drkntz/radiotelescope-PCB/README.md

# News
First place (tie), 2023 IEEE Susquehanna Section Capstone Competition. Project paper here: https://r2.ieee.org/susquehanna/wp-content/uploads/sites/24/2023/07/IEEE_RadioTelescopeControlSystem_Report.pdf
 
# Radio Telescope PCB
This Repository contains the design files for a control PCB for Penn State Harrisburg Radio telescope project. 

This project runs an embedded microcontroller PCB which controls the alt-az motor system for pointing a 3 meter dish. 
It communicates over USB with a PC.

Firmware repository: https://github.com/drkntz/radiotelescope-firmware

PC software: https://github.com/RidhaChowdhury/MiniRadioTelescope

Created by Zach Martin and Aaron Olsen.
Init date October 2022.

# System Overview

Block Diagram of Radio Telescope:

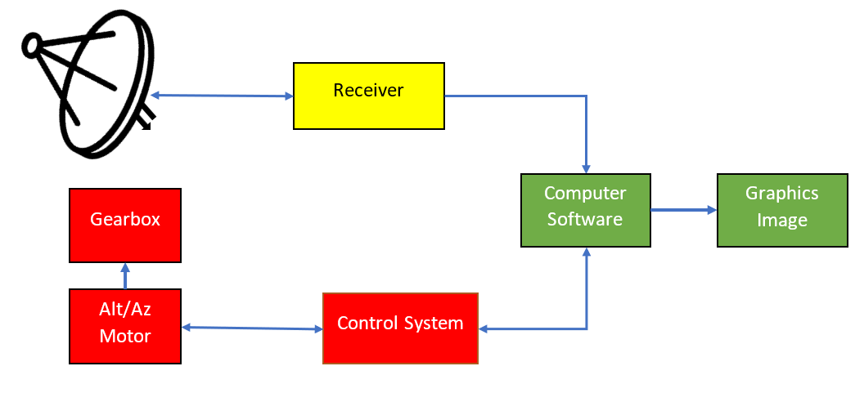
[picture p1: Docs/System_Overview.png]
System_Overview


Block Diagram of Radio Telescope Controller:

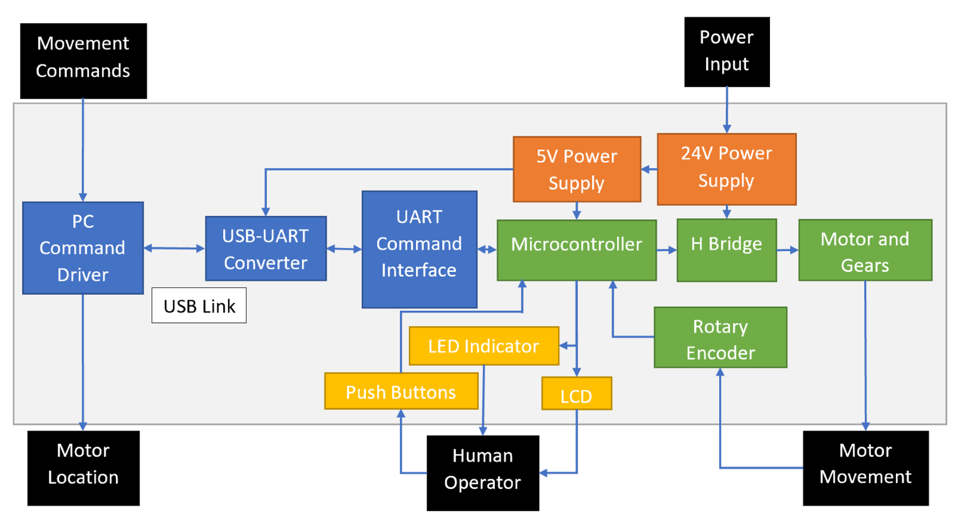
[picture p2: Docs/Control_System_Diagram.png]
Control_System_Diagram


# Schematic

PDF Printout

Schematic Pages:
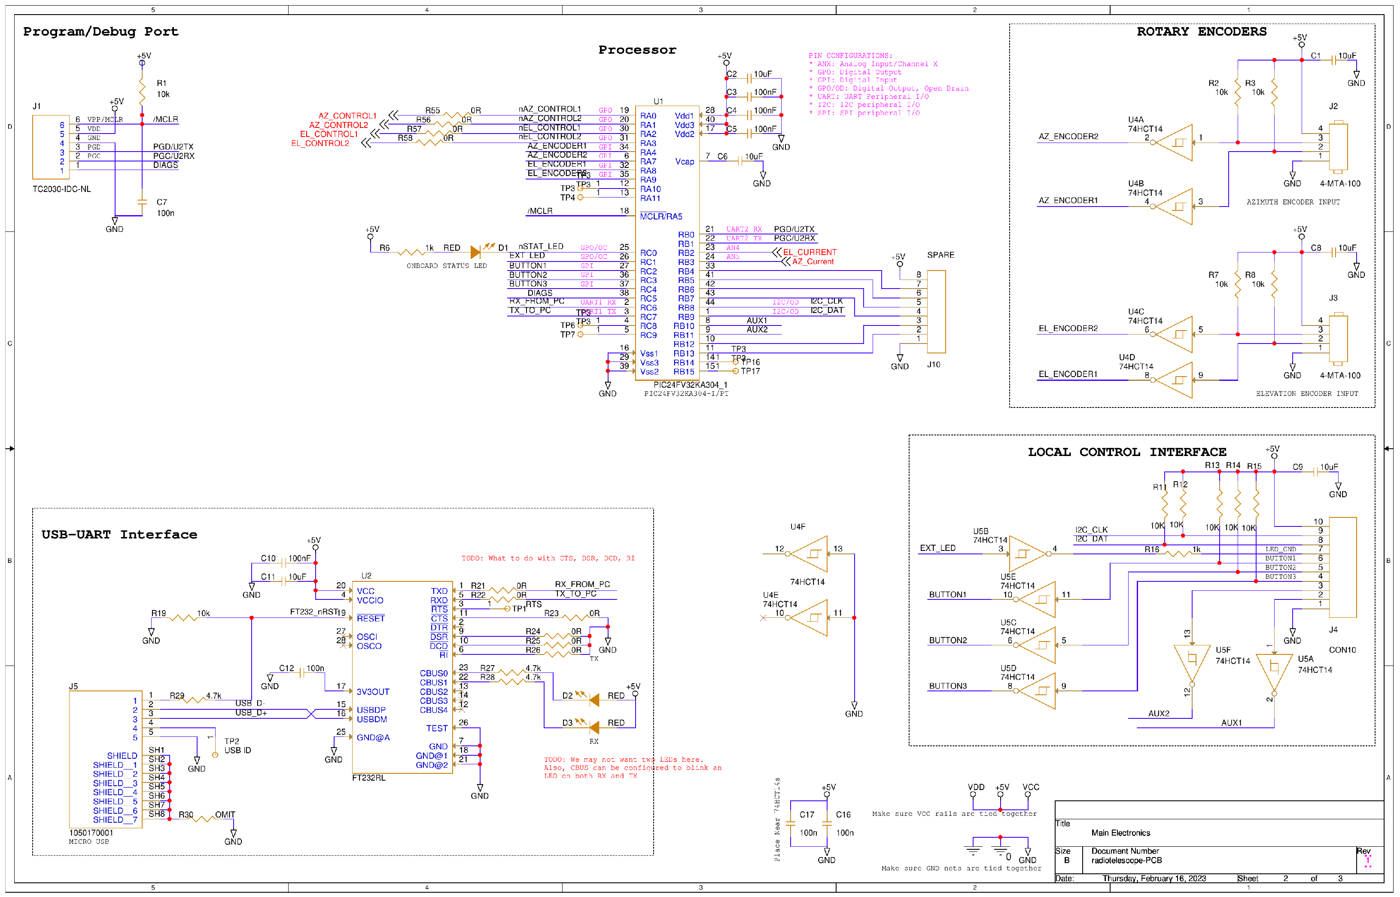
[picture p3: Docs/radiotelescope-SCH-V01_1.png]
SCH_1

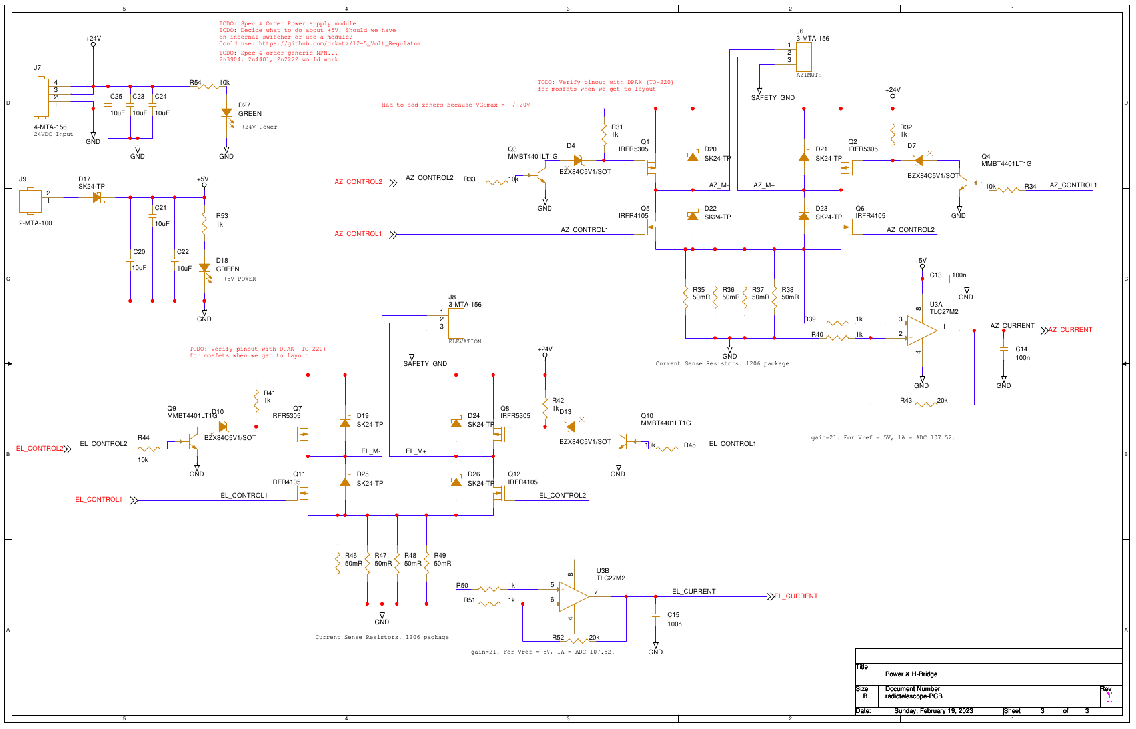
[picture p4: Docs/radiotelescope-SCH-V01_2.png]
SCH_2


# PCB Layout
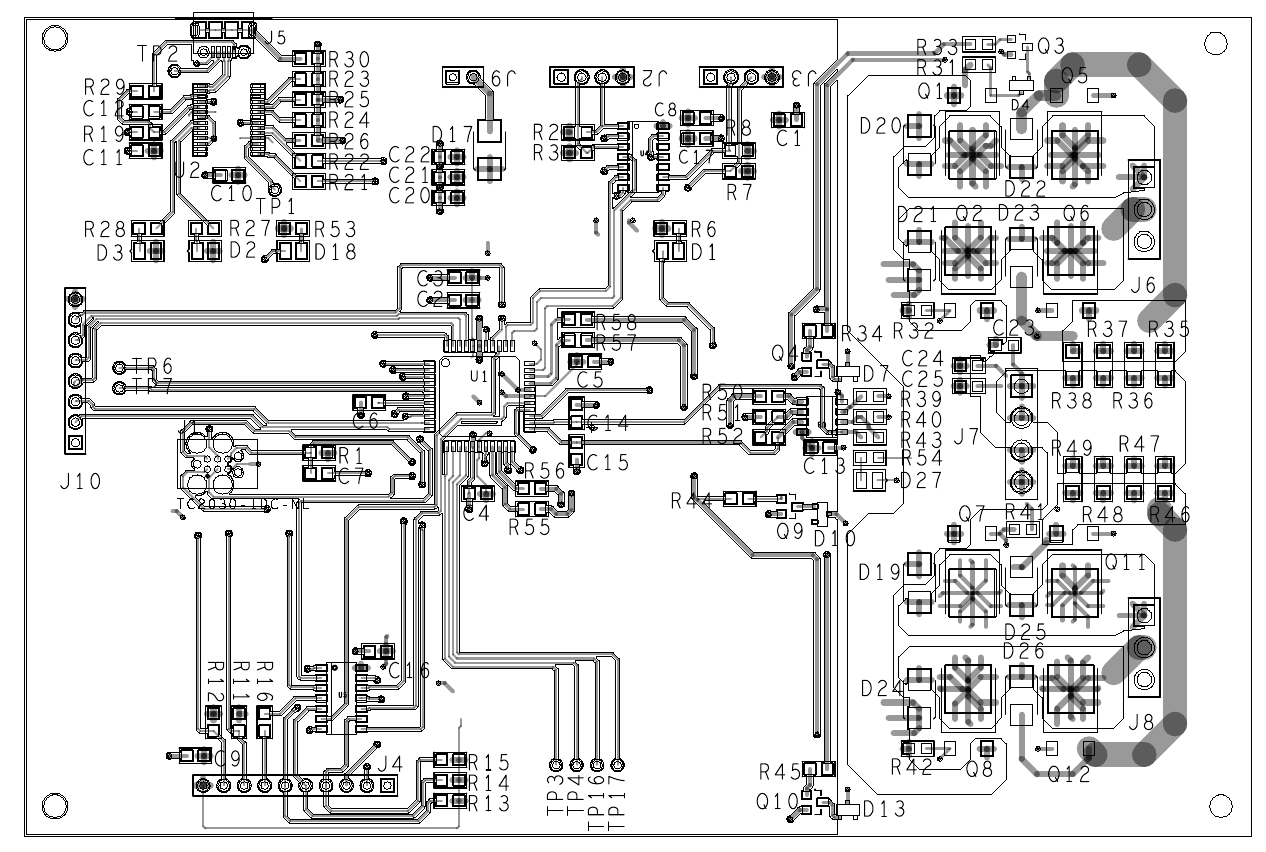
[picture p5: Docs/radiotelescope-LAY-V01.png]
PCB


# PCB 3-D Model
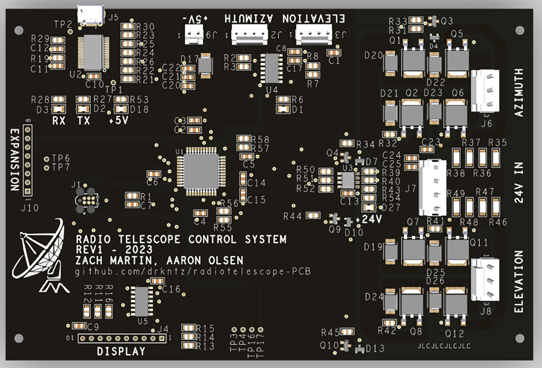
[picture p6: Docs/radiotelescope-3D-V01.png]
3D


# Completed Design

Assembled PCB:

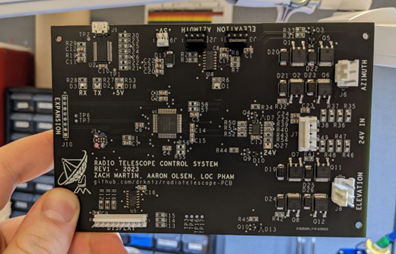
[picture p7: Docs/Assembled_PCB.png]
Assembled_PCB


Assembled System, including 3 foot prototype dish and alt-az motor system.

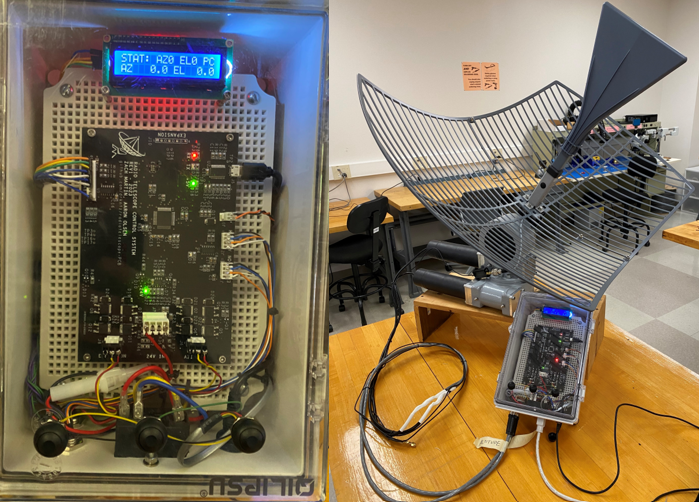
[picture p8: Docs/Assembled_System.png]
Assembled_System


# Example Video of Prototype

https://youtu.be/-fnis7qi-ZQ
