drkntz/radiotelescope-PCB/Main Project/allegro/gerbers/Screenshot 2023-02-20 102508.png

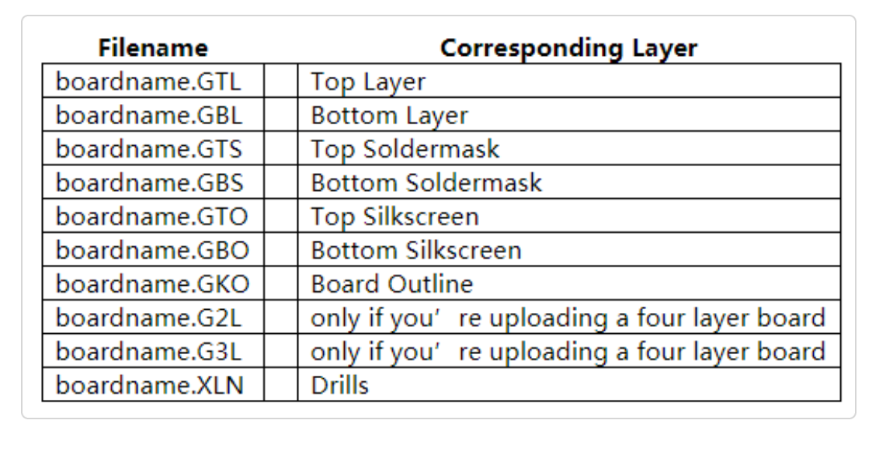
Main Project/allegro/gerbers/Screenshot 2023-02-20 102508.png
