drkntz/radiotelescope-PCB/Main Project/RADIOTELESCOPE.png

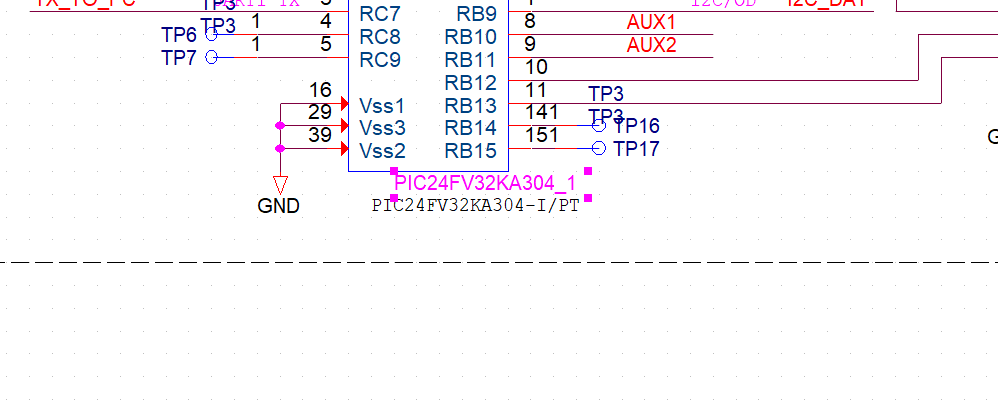
Main Project/RADIOTELESCOPE.png
