drkntz/radiotelescope-PCB/Simulation/hbridge/HBRIDGE.png

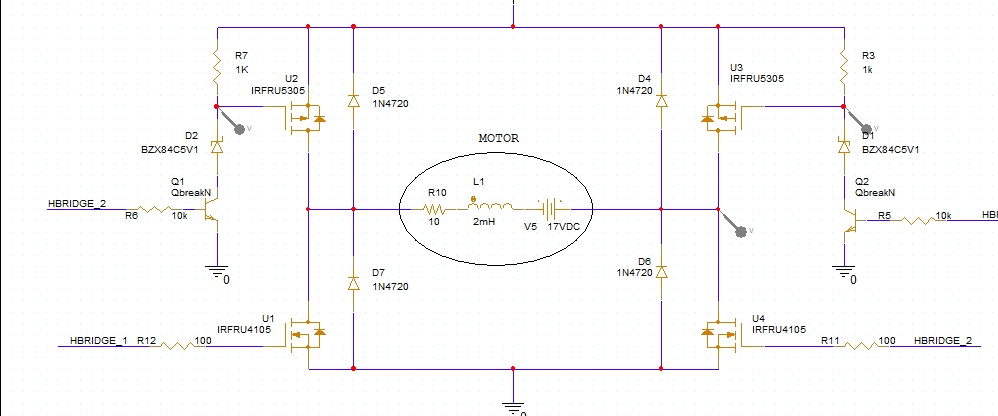
Simulation/hbridge/HBRIDGE.png
