drkntz/radiotelescope-PCB/Main Project/symbols/TC2030-IDC-NL.STEP

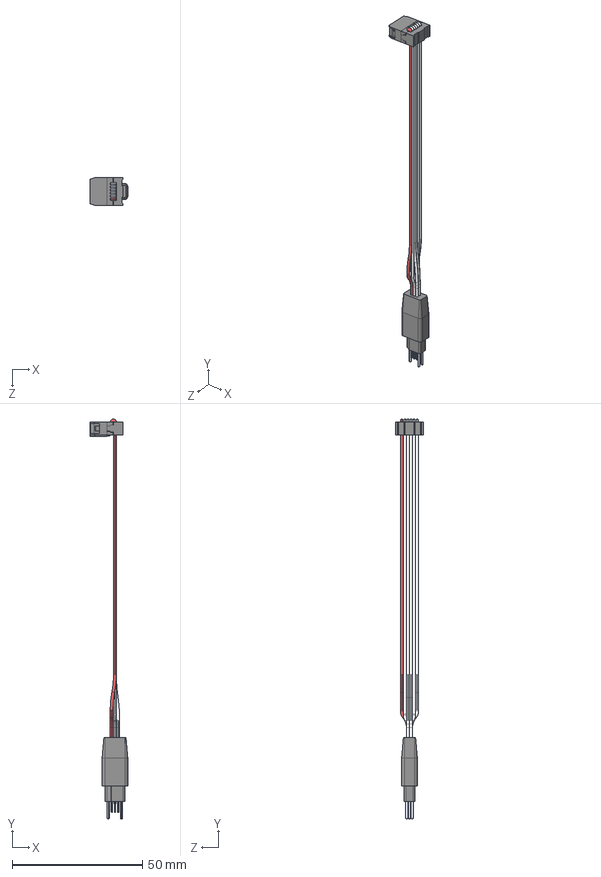
[picture p12: CAD file, 2023-02-01]
Main Project/symbols/TC2030-IDC-NL.STEP
14.5 x 153.6 x 10.7 mm
