drkntz/radiotelescope-PCB/Main Project/symbols/QFP80P1200X1200X120-44N.STEP

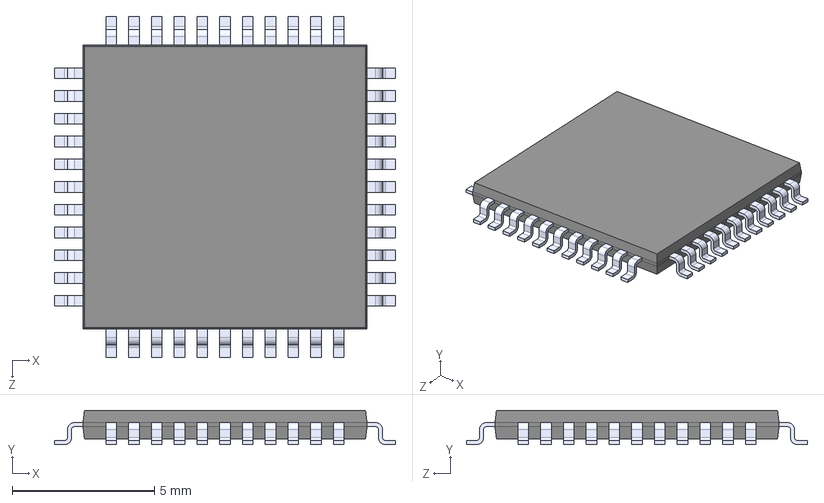
[picture p13: CAD file, 2023-01-16]
Main Project/symbols/QFP80P1200X1200X120-44N.STEP
12.0 x 1.20 x 12.0 mm
