drkntz/radiotelescope-PCB/Main Project/symbols/INTERFACE-FT232RL(SSOP28).STEP

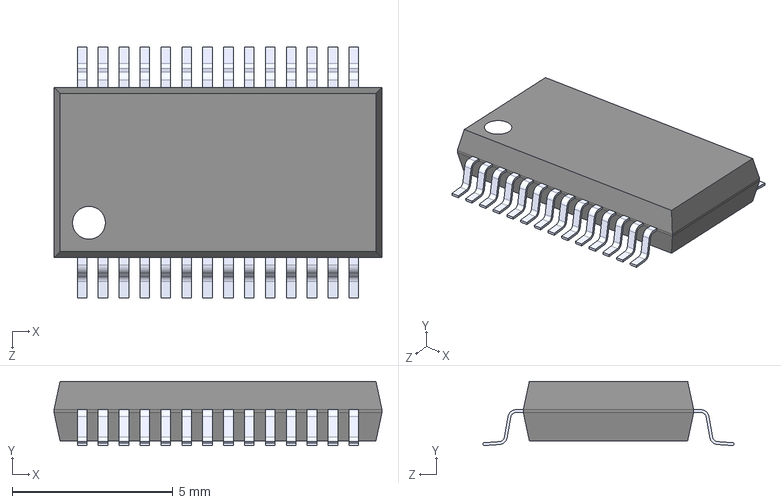
[picture p14: CAD file, 2022-11-22]
Main Project/symbols/INTERFACE-FT232RL(SSOP28).STEP
10.2 x 2.00 x 7.80 mm
