drkntz/radiotelescope-PCB/Main Project/symbols/1050170001.STEP

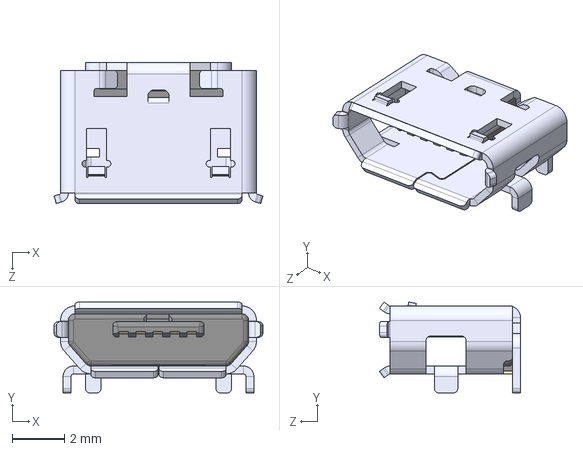
[picture p15: CAD file, 2022-11-22]
Main Project/symbols/1050170001.STEP
8.00 x 3.48 x 5.40 mm
