drkntz/radiotelescope-PCB/(list of files, cad)

Other CAD files:
Main Project/symbols/molex_1050170001.psm
Main Project/symbols/ssop28-065-102x52mm.psm
Main Project/symbols/tag_tc2030-idc-nl.psm
