drkntz/radiotelescope-PCB/Simulation/Simulation_Results.docx

# H-Bridge Simulation Data With PSPICE Default Parts

Simulation data from a simulation of H-bridge control. Simulated 11/23/2022 by Zach Martin.

Figure 1: Simulation Schematic

Figure 2: Simulation result

# Simulation With Vendor SPICE models 11/24/22

Imported vendor SPICE models, see “spice models” folder

Zach Martin, 11/24/22
