drkntz/radiotelescope-PCB/Main Project/allegro/radiotelescope-gerber-drawing.pdf

# R2TP3

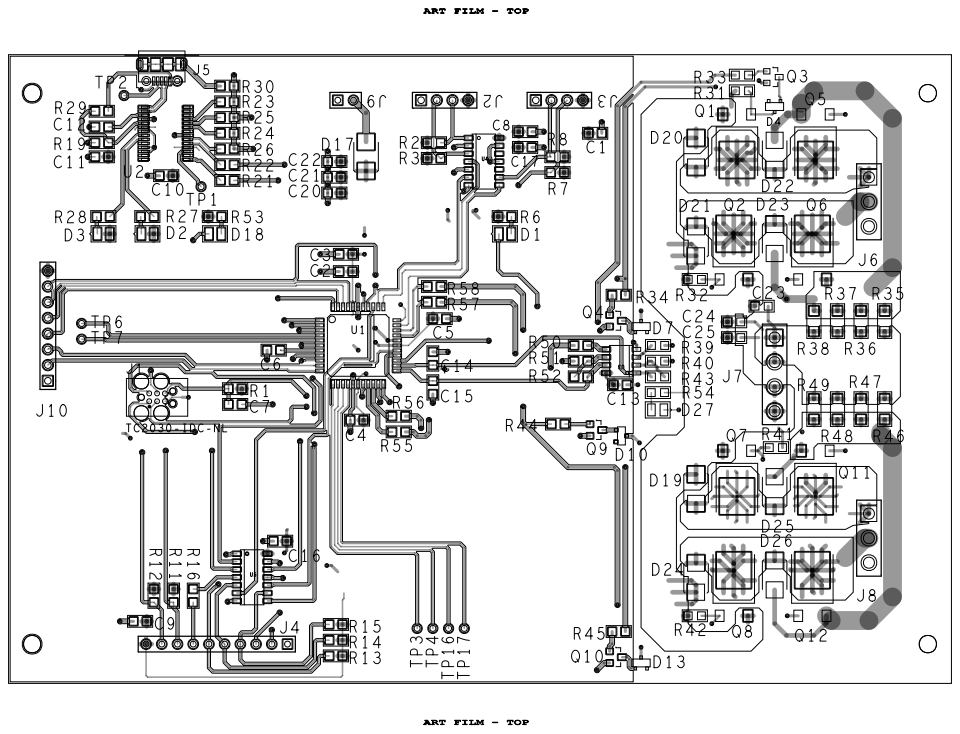
[picture p19: page 1]

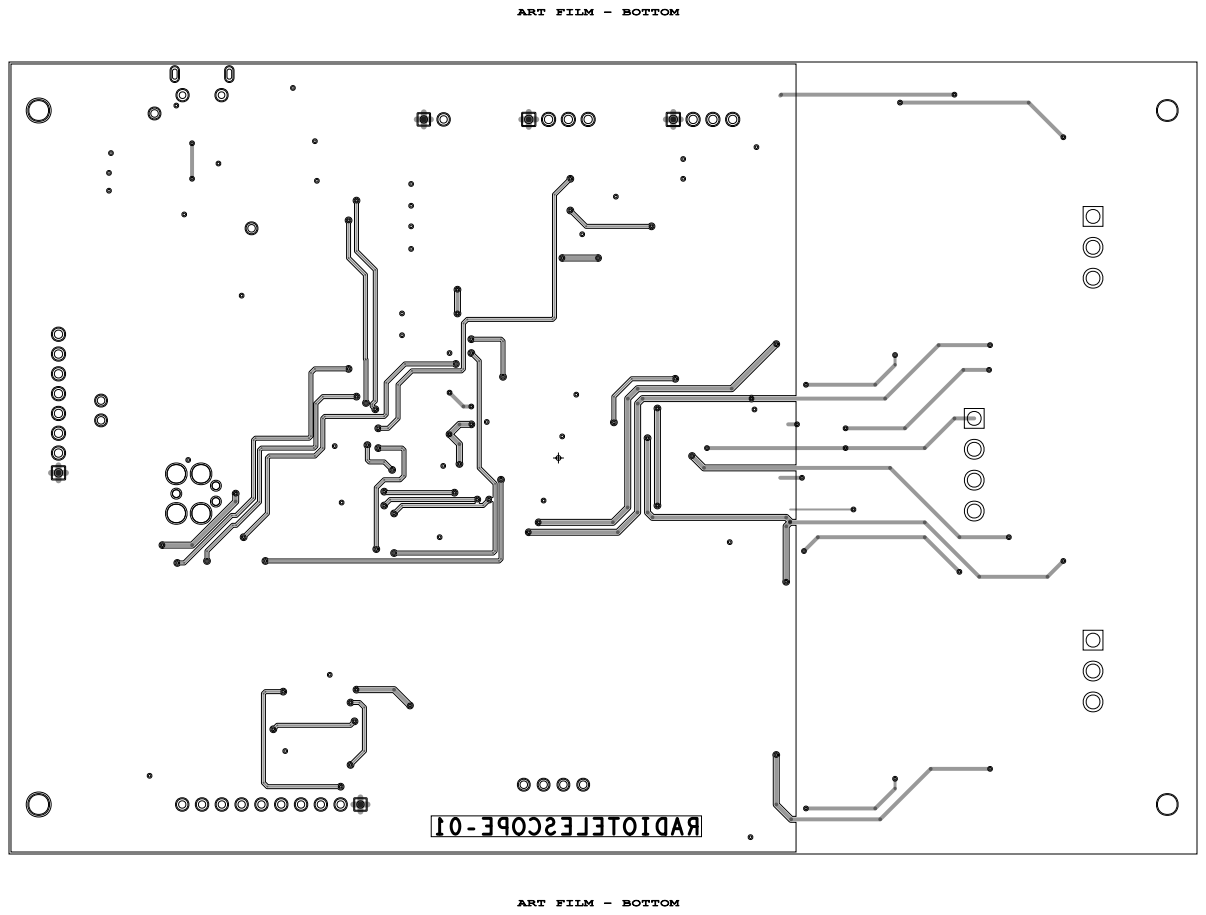
[picture p20: page 2]

ART FILM - BOTTOM

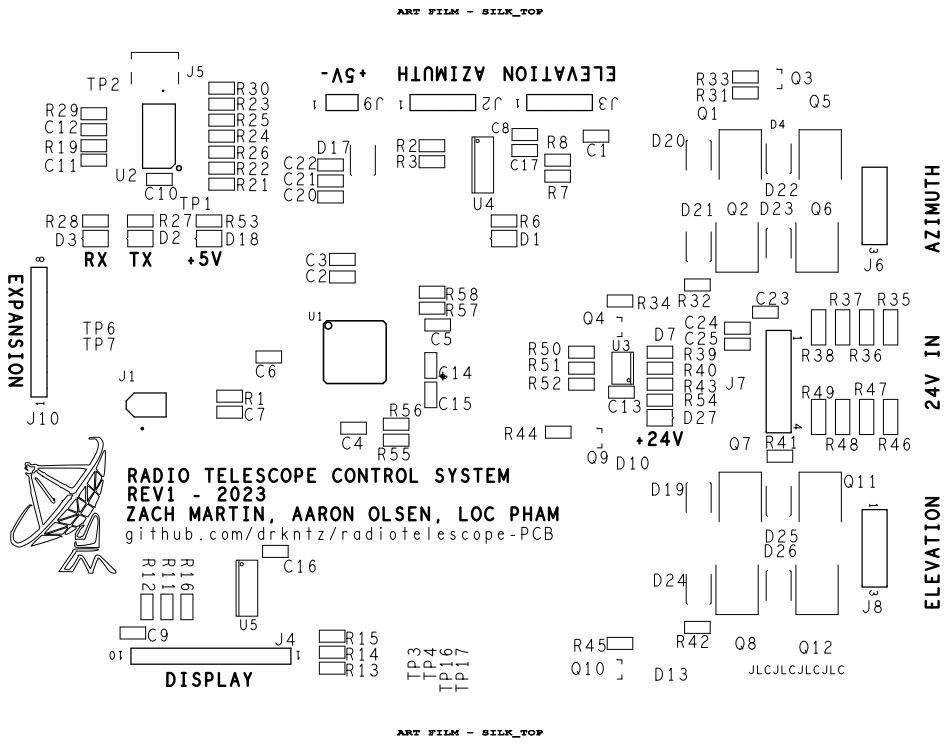
[picture p21: page 3]

RADIO TELESCOPE CONTROL SYSTEM
REV1 - 2023
ZACH MARTIN, AARON OLSEN, LOC PHAM
github.com/drkntz/radiotelescope-PCB

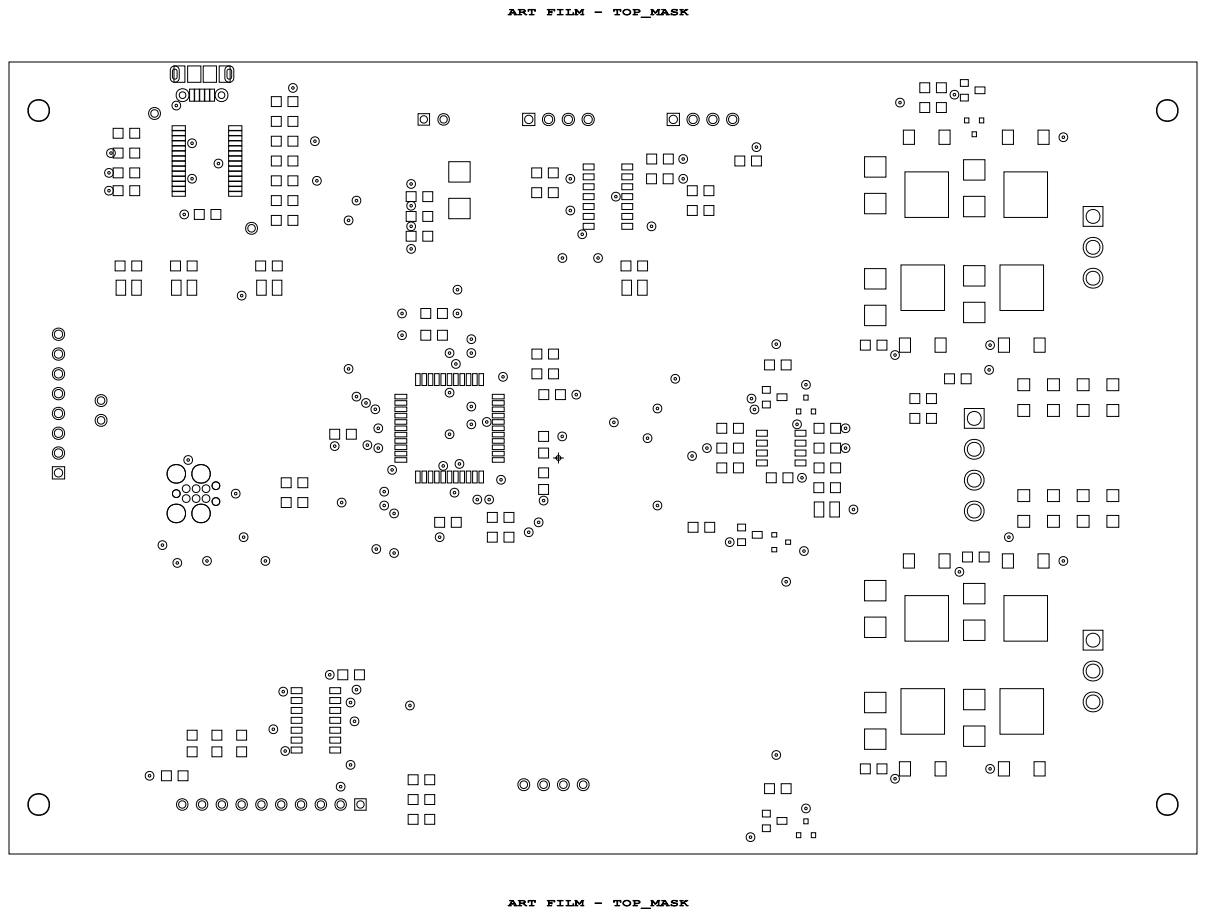
[picture p22: page 4]
ART FILM - TOP_MASK

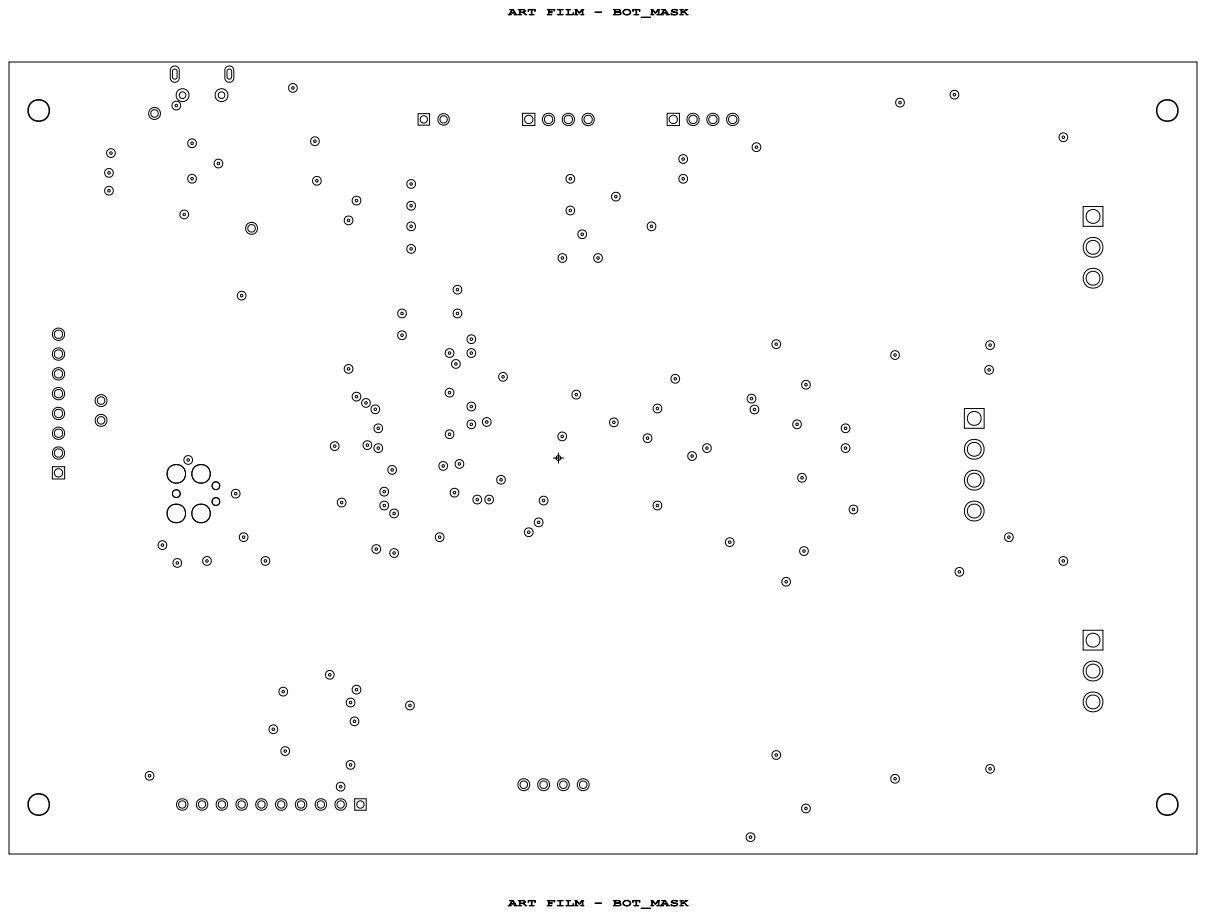
[picture p23: page 5]
ART FILM - BOT_MASK

ART FILM - BOARD_GEO

ART FILM - BOARD_GEO
