drkntz/radiotelescope-PCB/Main Project/allegro/radiotelescope-gerber-pdf.pdf

# R2TP3



ART FILM - BOTTOM

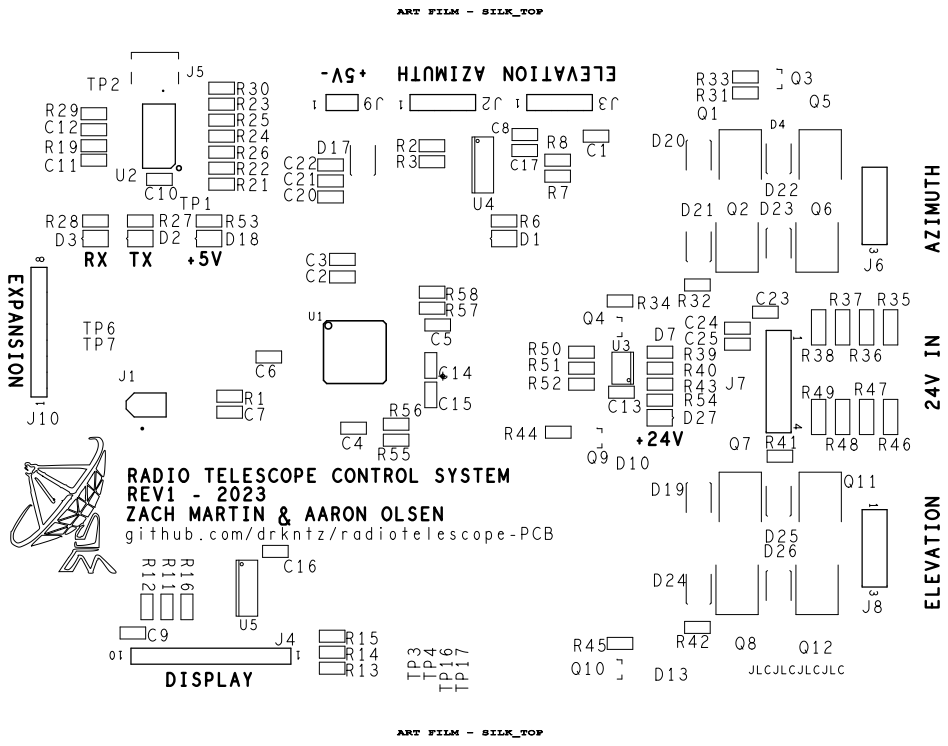
[picture p24: page 3]

RADIO TELESCOPE CONTROL SYSTEM
REV1 - 2023
ZACH MARTIN & AARON OLSEN
github.com/drkntz/radiotelescope-PCB

ART FILM - TOP_MASK

ART FILM - BOT_MASK

ART FILM - BOARD_GEO

ART FILM - BOARD_GEO
