drkntz/radiotelescope-PCB/Main Project/allegro/radiotelescope.pdf

5.85

6.00 TP4

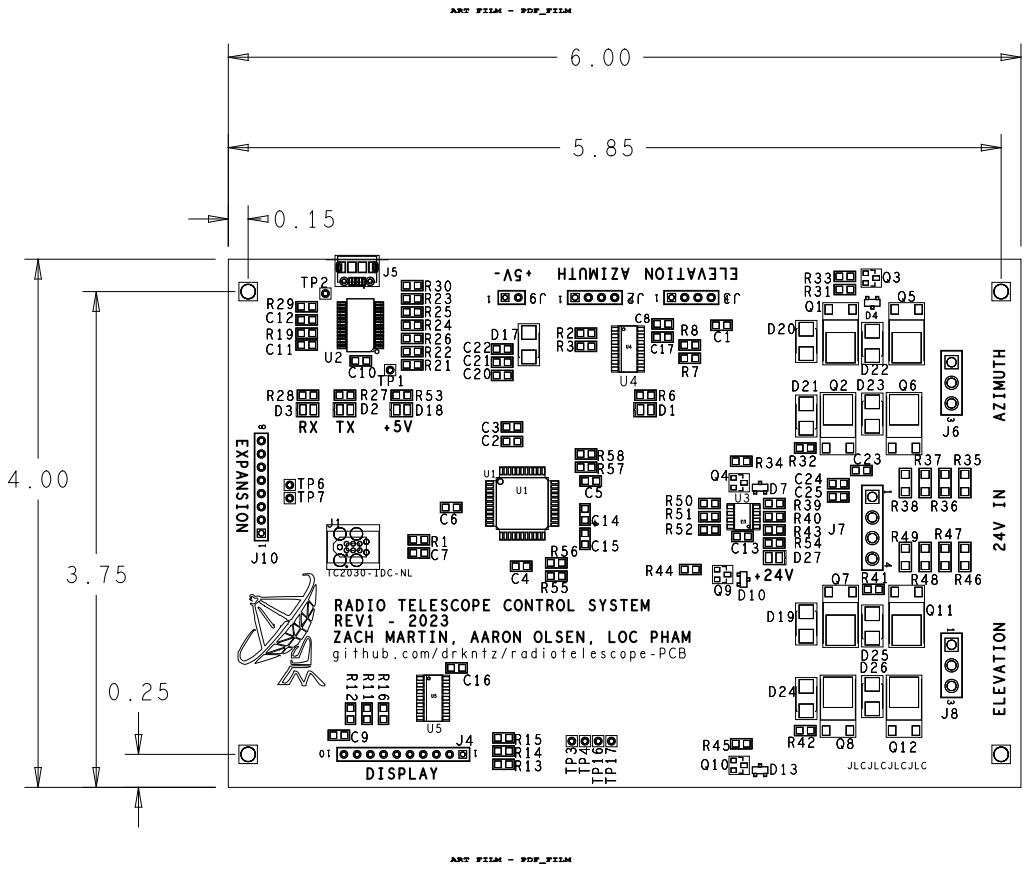
[picture p25: page 1]
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
