drkntz/radiotelescope-PCB/Main Project/allegro/radiotelescope-PCB.pdf

# R2TP3

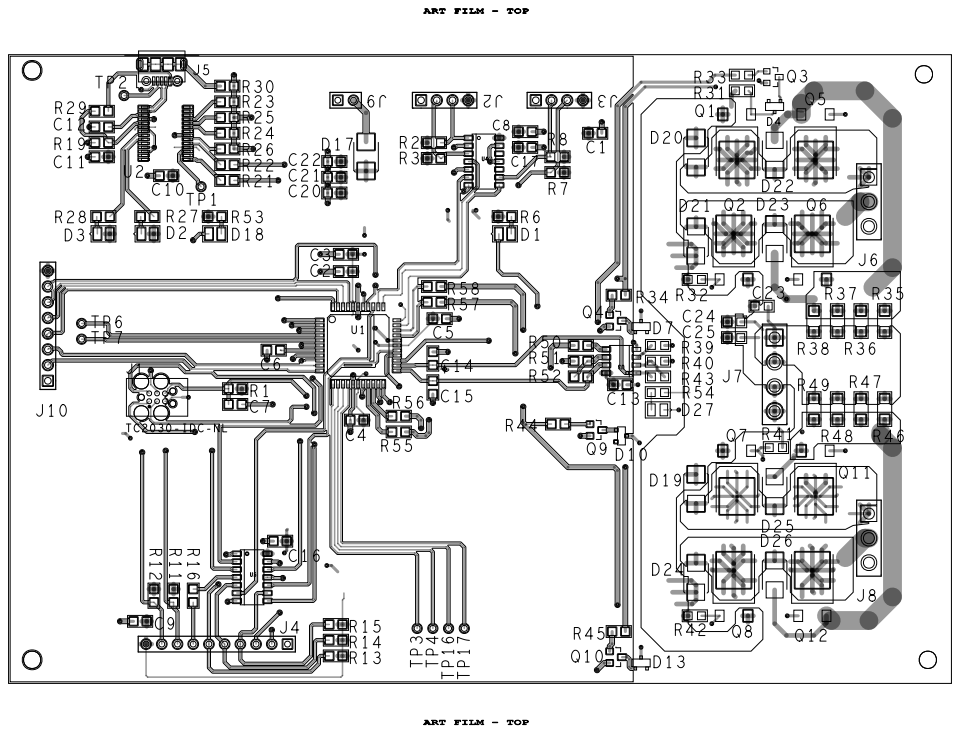
[picture p26: page 1]

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

ART FILM - BOARD_GEO

ART FILM - BOARD_GEO
