drkntz/radiotelescope-PCB/Simulation/hbridge/radiotelescope.pdf

D | D

# Radio Telescope Control System

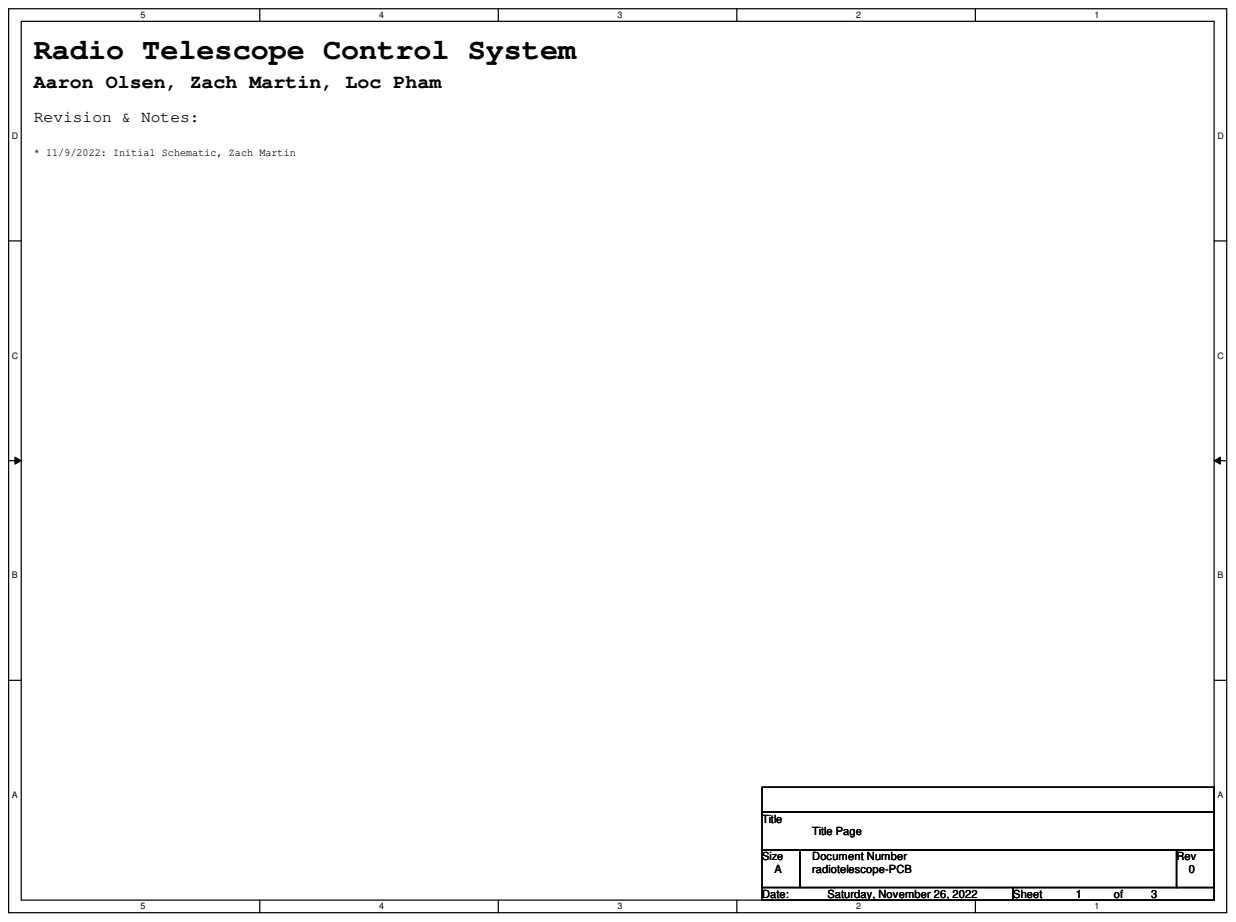
[picture p27: page 1]
Revision & Notes:; Title; Size; Document Number; Rev; Date:; Sheet; radiotelescope-PCB; Title Page; 3Saturday, November 26, 2022

Aaron Olsen, Zach Martin, Loc Pham

* 11/9/2022: Initial Schematic, Zach Martin

## ROTARY ENCODERS

## Program/Debug Port

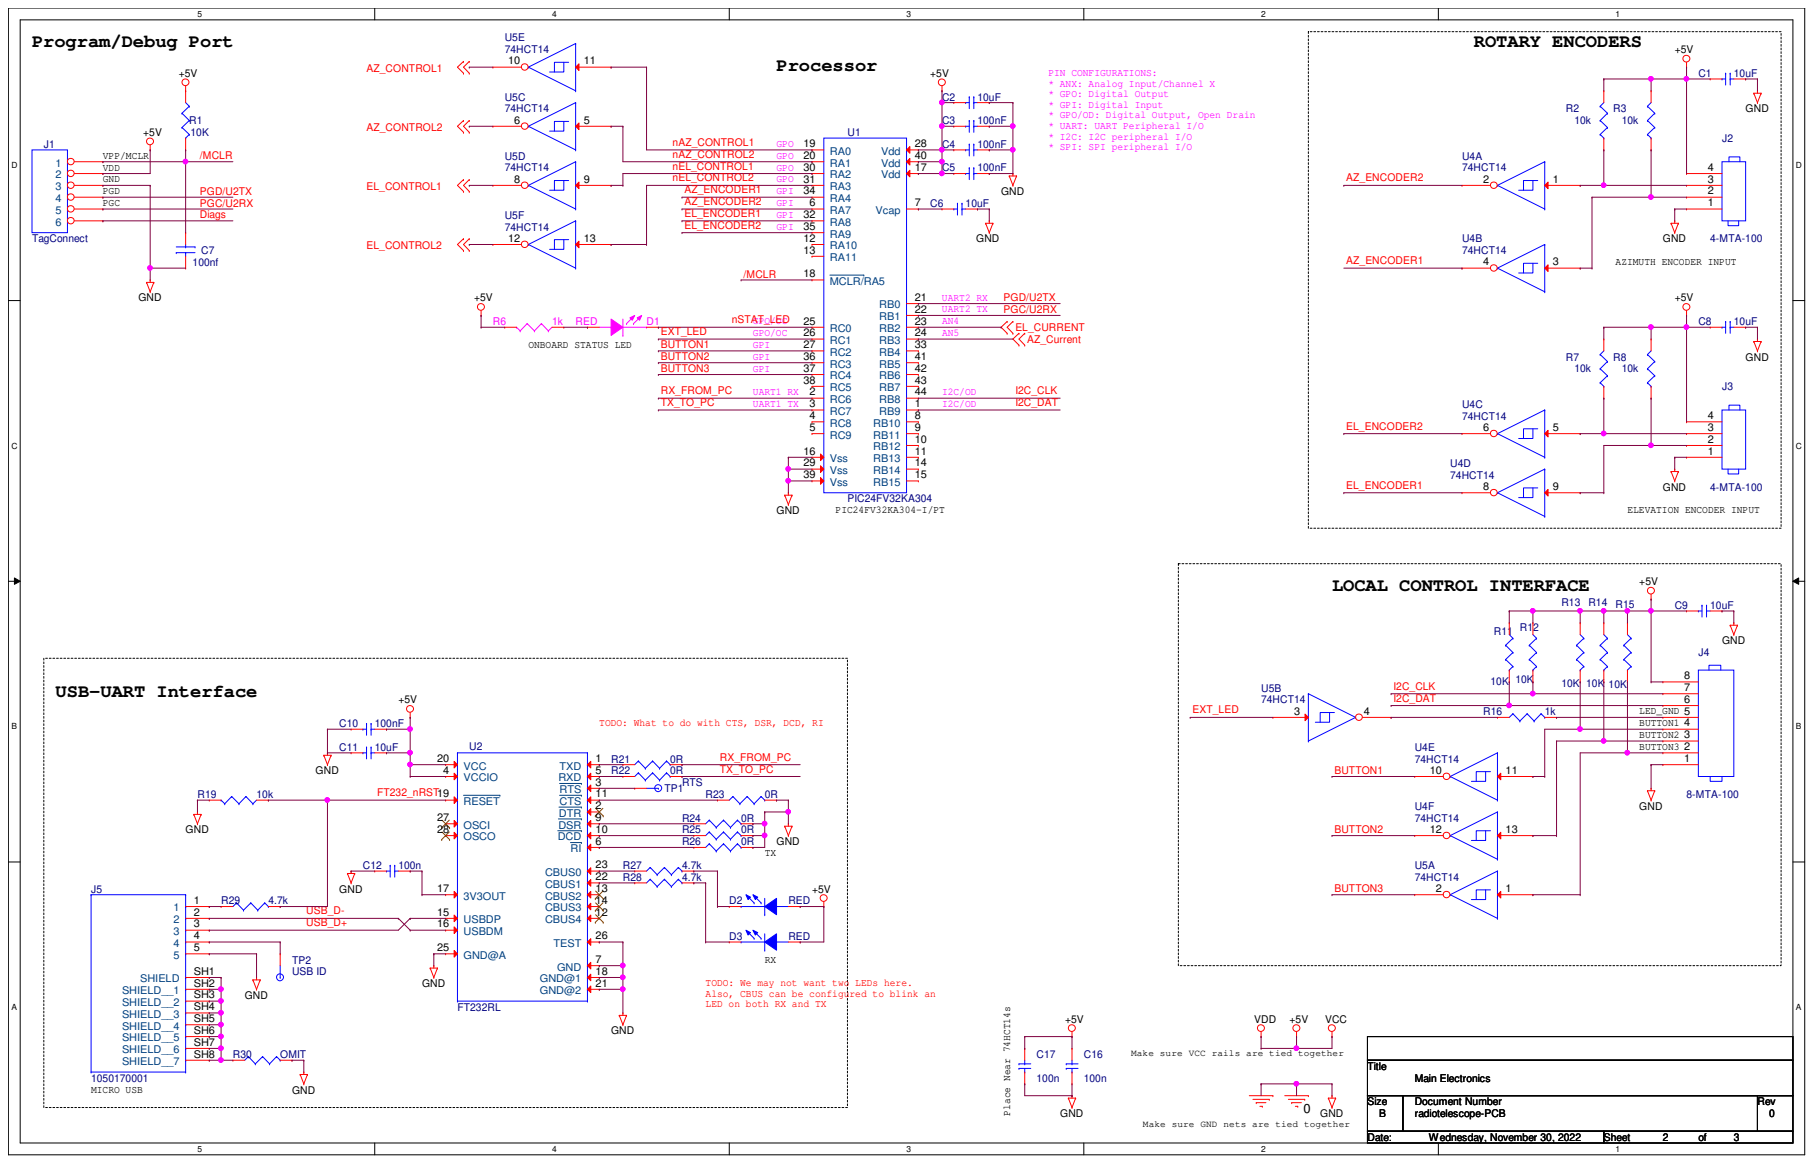
[picture p28: page 2]

PIN CONFIGURATIONS:
* ANX: Analog Input/Channel X
* GPO: Digital Output
* GPI: Digital Input
* GPO/OD: Digital Output, Open Drain
* UART: UART Peripheral I/O
* I2C: I2C peripheral I/O
* SPI: SPI peripheral I/O

TODO: What to do with CTS, DSR, DCD, RI

BUTTON1 4
BUTTON2 3

TODO: We may not want two LEDs here.
Also, CBUS can be configured to blink an
LED on both RX and TX

Make sure VCC rails are tied together

Make sure GND nets are tied together

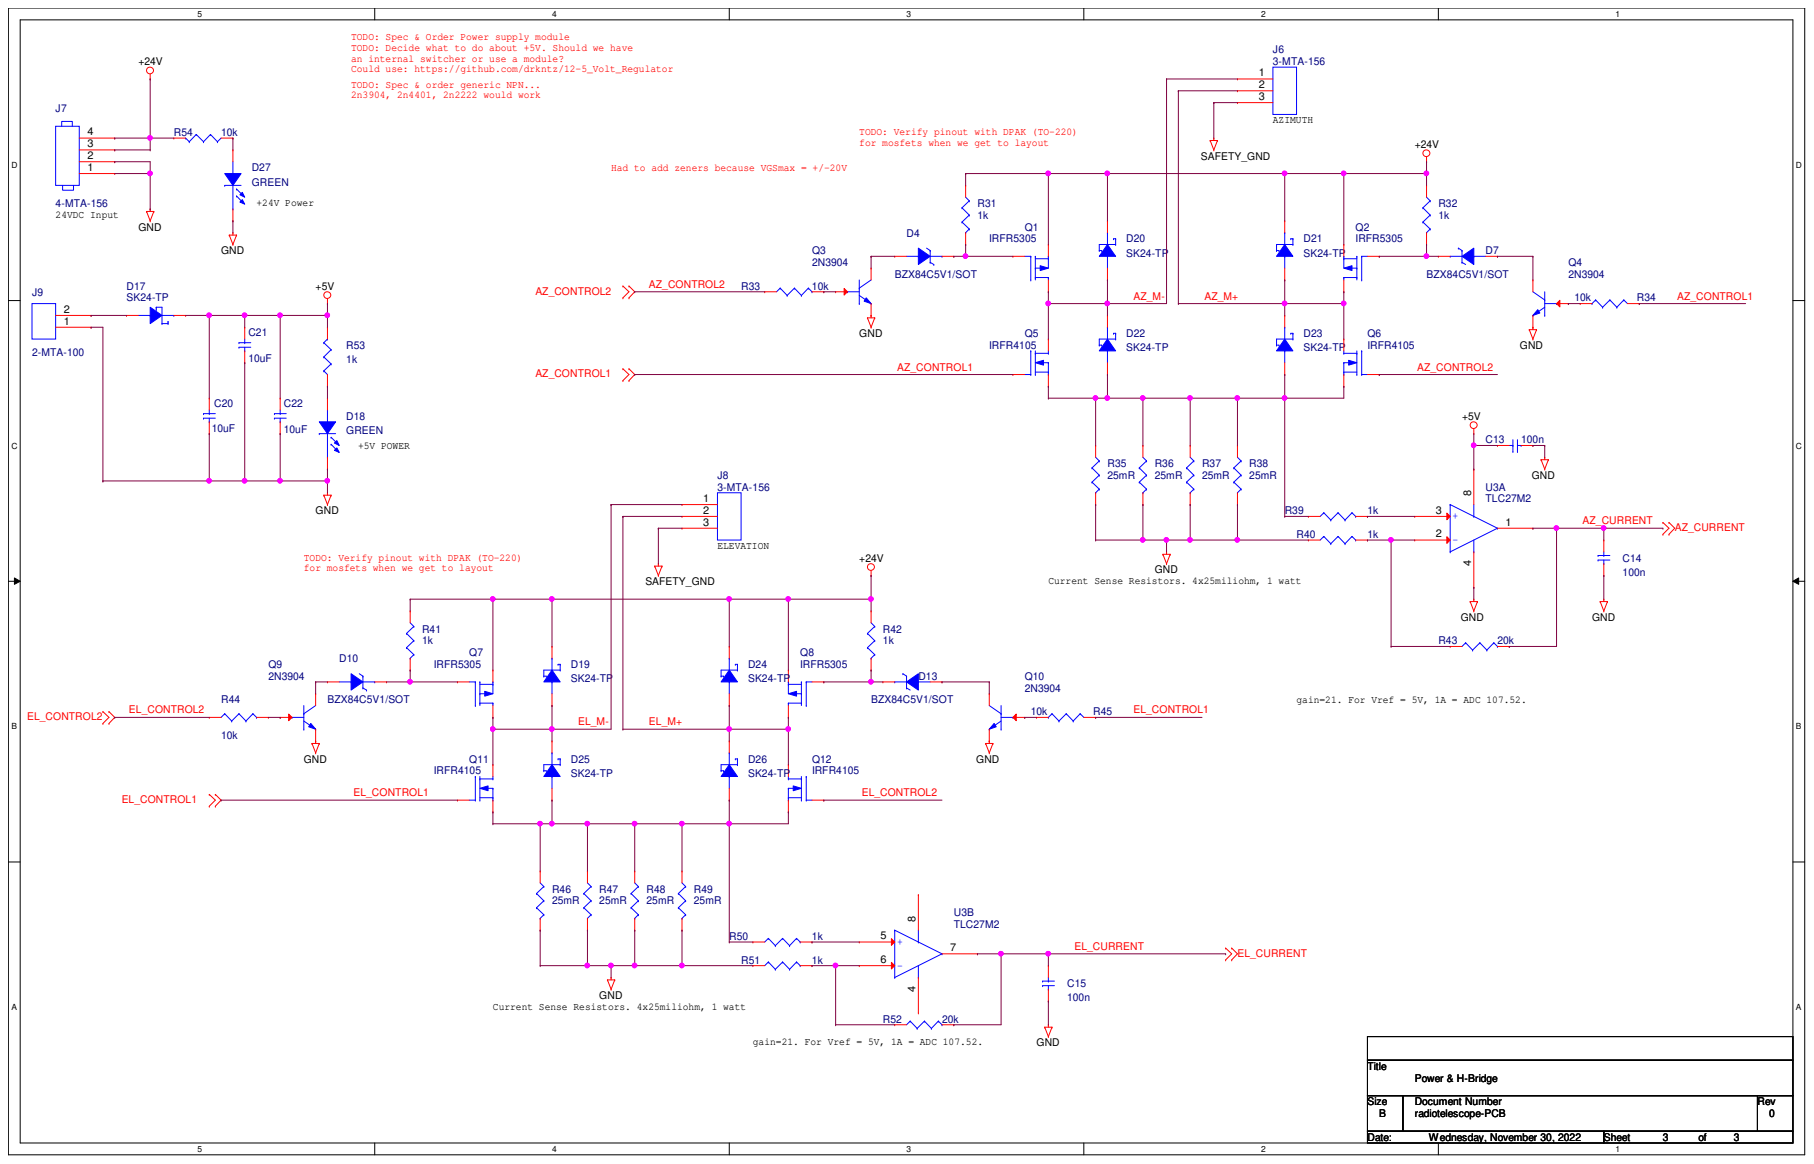
[picture p29: page 3]

TODO: Spec & Order Power supply module
TODO: Decide what to do about +5V. Should we have
an internal switcher or use a module?
Could use: https://github.com/drkntz/12-5_Volt_Regulator
TODO: Spec & order generic NPN...
2n3904, 2n4401, 2n2222 would work

TODO: Verify pinout with DPAK (TO-220)
for mosfets when we get to layout

Had to add zeners because VGSmax = +/-20V

Current Sense Resistors. 4x25miliohm, 1 watt

gain=21. For Vref = 5V, 1A = ADC 107.52.
