drkntz/radiotelescope-PCB/Simulation/hbridge/hbridge.pdf

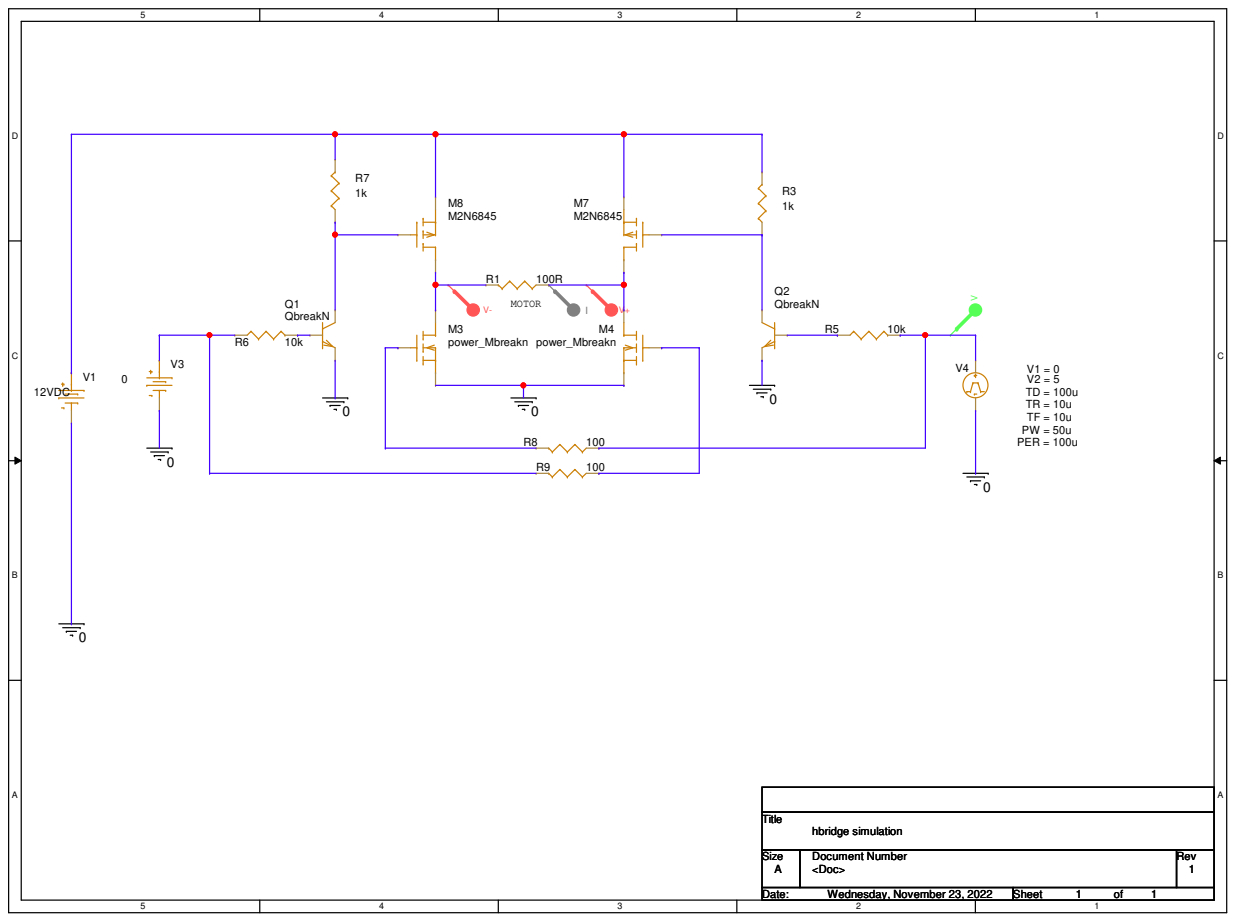
[picture p30: page 1]
