drkntz/radiotelescope-PCB/(list of files, drawings)

Other design files:
Main Project/DESIGN1.DSN
Main Project/Design1.opj
Main Project/LIBRARY1.OLB
Main Project/RADIOTELESCOPE.DSN
Main Project/radiotelescope.opj
Main Project/symbols/1050170001.OLB
Main Project/symbols/INTERFACE-FT232RLSSOP28.OLB
Main Project/symbols/TC2030-IDC-NL.OLB
Simulation/hbridge/HBRIDGE.DSN
Simulation/hbridge/hbridge.opj
Simulation/spice models/IRFR4105.OLB
Simulation/spice models/IRFR5305.OLB
