drkntz/radiotelescope-PCB/(commit log)

2022-11-09 Started main schematic. Added processor & debug header
    [RADIOTELESCOPE.DSN, radiotelescope.opj]
2022-11-22 Added FT232 USB-UART interface. Added PDF printout & README
    [1050170001.OLB, 1050170001.STEP, DESIGN1.DSN, Design1.opj, INTERFACE-FT232RL(SSOP28).STEP, INTERFACE-FT232RLSSOP28.OLB, RADIOTELESCOPE.DSN, molex_1050170001.psm]
2022-11-23 Simulation for H-bridge. Added H-bridge to main schematic
    [HBRIDGE.DSN, RADIOTELESCOPE.DSN, hbridge.opj, radiotelescope.opj]
2022-11-24 Added Zener diodes to H-bridge to protect PMOS Vsg_max. Import vendor SPICE models & re-ran simulation. Update README.
    [HBRIDGE.DSN, IRFR4105.OLB, IRFR5305.OLB, RADIOTELESCOPE.DSN, hbridge.opj, radiotelescope.opj]
2022-11-26 add display interface w/leds & PB. Add encoders, added opamp tlc27m2, connected inter-page references to main MCU
    [RADIOTELESCOPE.DSN, hbridge.opj, radiotelescope.opj]
2022-11-30 added 74HCT14 buffers to i/o and H-bridge drivers
    [RADIOTELESCOPE.DSN, radiotelescope.opj]
2022-11-30 added power input for +5v, added power LEDs, changed snubber diodes to schottky sk24 type
    [RADIOTELESCOPE.DSN, radiotelescope.opj]
2023-01-16 Some changes from design review, added test points
    [RADIOTELESCOPE.DSN, radiotelescope.opj]
2023-01-16 Added footprint for PIC, added footprints for caps, LEDs, and resistors except for current shunts
    [EDI2CAP.CFG, INTERFACE-FT232RL(SSOP28).STEP, INTERFACE-FT232RLSSOP28.OLB, QFP80P1200X1200X120-44N.STEP, RADIOTELESCOPE.DSN, radiotelescope.opj, ssop28-065-102x52mm.psm]
2023-02-01 Updated footprints, fix DRC
    [EDI2CAP.CFG, LIBRARY1.OLB, RADIOTELESCOPE.DSN, TC2030-IDC-NL.OLB, TC2030-IDC-NL.STEP, cases.cfg, radiotelescope.opj, tag_tc2030-idc-nl.psm]
2023-02-02 changed PCB footprint files and some other stuff to get rid of allegro netlisting errors. Started blank allegro project
    [1050170001.OLB, 1050170001.STEP, EDI2CAP.CFG, INTERFACE-FT232RL(SSOP28).STEP, INTERFACE-FT232RLSSOP28.OLB, QFP80P1200X1200X120-44N.STEP, RADIOTELESCOPE.DSN, TC2030-IDC-NL.OLB]
2023-02-03 started layout in allegro, hbridge
    [cases.cfg, radiotelescope.brd, radiotelescope.opj]
2023-02-03 Hbridges layout
    [RADIOTELESCOPE.DSN, radiotelescope.brd, radiotelescope.opj]
2023-02-05 Completing both H-bridges and current sensors
    [RADIOTELESCOPE.DSN, radiotelescope.brd, radiotelescope.opj]
2023-02-09 Added all components to PCB and laid out ftdi USB-UART section
    [HBRIDGE.DSN, RADIOTELESCOPE.DSN, hbridge.opj, radiotelescope.brd, radiotelescope.opj]
2023-02-18 Add Aaron's edits: PCB layout, move u5a inverter, move extra pin connections, silk screen edits, new traces for logic section
    [RADIOTELESCOPE.DSN, radiotelescope.brd, radiotelescope.opj]
2023-02-18 Update pours, update tag-connect, update silk and docs
    [radiotelescope.brd, tag_tc2030-idc-nl.psm]
2023-02-19 save point - some changes
    [RADIOTELESCOPE.DSN, radiotelescope.brd, radiotelescope.opj]
2023-02-20 save point gerbers
    [art_param.txt, nc_param.txt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]
2023-02-20 Gerbers, update docs
    [RADIOTELESCOPE.DSN, pdf_out_config.txt, radiotelescope.brd, radiotelescope.opj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]
2023-04-25 some cleanup
    [HBRIDGE.DSN, hbridge.opj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]
2023-04-27 changing some of the documentation
    [RADIOTELESCOPE.DSN, radiotelescope.brd, radiotelescope.opj]
